jiujie51/RUI_lora_alarm/doc/项目方案梳理报告.md

# LoRa报警系统 — 方案梳理报告（终端设备视角）

> 2026-07-04 | NCS v3.3.0 | RAK4631 (nRF52840 + SX1262)
>
> **职责边界**：终端设备（Hub/Badge）由我们开发。服务器/LNS（SimulAlert）已部署，我们只需要遵守与服务器的协议约定。网关（RAK7289CV2）是现成设备，配置连到 LNS 即可。

---

## 一、系统架构与职责

```
┌──────────────────┐         ┌──────────────┐         ┌─────────────────────┐
│  Hub / Badge     │  LoRa   │ RAK7289CV2   │  WSS    │ SimulAlert LNS      │
│  (我们开发)       │ ←─────→ │ (现成, 配置)   │ ←─────→ │ wss://lns.simulalert │
│                  │  US915  │              │         │ .com:8887           │
│  RAK4631         │         │ Basic Station│         │                     │
│  NCS v3.3.0      │         │              │         │ + App Server        │
└──────────────────┘         └──────────────┘         │ + Dashboard         │
                                                       └─────────────────────┘
  我们的职责:                   网关职责:                   SimulAlert 职责:
  ✅ 0xAA55 协议编解码         ✅ LoRa ↔ IP 透传          ✅ 设备管理/入网
  ✅ OTAA 入网 (Class B)       ✅ GPS + Beacon            ✅ 协议编解码
  ✅ 告警状态机                 ✅ 频段匹配 US915           ✅ 告警路由/广播
  ✅ BLE 广播/扫描              ❌ 不解析 0xAA55            ✅ Dashboard
  ✅ 执行器 (LED/Buzz/Vib)                                  ✅ 多播组管理
  ❌ 不管理 Ping Slot                                       ✅ Ping Slot 配置
```

---

## 二、设备与服务器的约定（核心）

### 2.1 LoRaWAN 入网约定

| 约定项 | 设备侧（固件） | 服务器侧（SimulAlert LNS） |
|---|---|---|
| 入网方式 | OTAA | OTAA |
| MAC 版本 | 1.0.3 | 1.0.3 |
| Class | B | B |
| 频段 | US915 | US915 |
| 凭证写入 | 生产烧录到 Flash ConfigStore | DevEUI/JoinEUI/AppKey 预先注册 |
| AppKey | **一机一密**（固件从 ConfigStore 读取） | 每台设备独立注册 |
| NVM 持久化 | 启用（掉电不丢会话） | — |
| Ping Slot | **不管**（服务器 Device Profile 配置） | 由服务器侧配置周期 |
| 入网重试 | 无限重试 + 指数退避 (10s→20s→…→900s) | 入网请求无限制 |
| 离线模式 | 入网期间 BLE/OLED/按键正常可用 | — |

### 2.2 FPort 分配约定

| FPort | 方向 | 内容 | 说明 |
|---|---|---|---|
| 10 | 上行 | Badge 心跳 (CMD 0x00) | 必须与此 FPort 一致，服务器按此路由 |
| 11 | 上行 | Hub 心跳 (CMD 0x00) | 同上 |
| 20 | 上行 | 业务数据 (CMD 0x01/0x02) | 电量、按键事件 |
| 20 | 下行 | **全部下行**（单播+多播） | 通过 CMDID + group/room 区分 |

> ⚠️ Port 0/200/201/202 是 LoRaWAN MAC 层保留端口，设备固件不可占用。

### 2.3 应用帧格式约定（0xAA55 协议）

```
┌──────┬──────┬──────┬──────┬──────┬────────┬────────┬──────────┐
│ 0xAA │ 0x55 │ ver  │ ctrl │CMDID │length  │ CRC16  │  data    │
│  1B  │  1B  │  1B  │  1B  │  1B  │  2B BE │  2B    │   N B    │
└──────┴──────┴──────┴──────┴──────┴────────┴────────┴──────────┘
```

| 字段 | 长度 | 说明 |
|---|---|---|
| 帧头 | 2B | 固定 `0xAA 0x55` |
| ver | 1B | 协议版本，当前 `0x01` |
| ctrl | 1B | 控制标志，上行固定 `0x00` |
| CMDID | 1B | 指令 ID |
| length | 2B | 帧总长度（含帧头和 CRC），大端序 |
| CRC16 | 2B | CRC16/XMODEM (poly=0x1021, init=0x0000)，覆盖除 CRC 自身外全部字节 |
| data | N | 变长数据 |

**测试向量**：`{0xAA,0x55,0x01,0x00,0x00,0x08,0x00,0x03}` → CRC16 = `0x58C7`

### 2.4 上行 CMDID（设备 → 服务器）

| CMDID | 名称 | FPort | 触发条件 | data 格式 |
|---|---|---|---|---|
| 0x00 | Heartbeat | 10(Badge)/11(Hub) | 每 5min | `{dev_type(1B), group_id(1B)}` |
| 0x01 | Power | 20 | 电量变化≥5% 且间隔≥5min | `{dev_type(1B), power_pct(1B)}` |
| 0x02 | KeyEvent | 20 | 按键确认 + BLE 扫描完成 | `{button(1B), motion(1B), rssi(1B), hub_mac(6B), lat(4B), lon(4B)}` |

**字段说明**：
- `dev_type`: `0x00`=Badge, `0x01`=Hub
- `button`: 按键 ID (Red/Blue/Yellow/Green), `0xFF`=静默定位
- `motion`: 保留（运动检测），当前填 `0`
- `rssi`: BLE 扫描到的 Hub RSSI，取绝对值（无符号）
- `hub_mac`: BLE 扫描到的最强 Hub 的 MAC 地址（6 字节），无 Hub 时填 `00:00:00:00:00:00`
- `lat/lon`: int32 大端，GPS 有效时填坐标，无效时填 `0x90000001` / `0x18000001`

### 2.5 下行 CMDID（服务器 → 设备）

| CMDID | 名称 | 方向 | 设备处理 |
|---|---|---|---|
| 0x03 | Code（告警） | 多播 | group_id + room_id 过滤 → alarm_sm_set() |
| 0x04 | Code Setting | 单播 | 更新 actuator 配置 → Flash 保存 |
| 0x05 | LED Control | 单播 | 直接控 LED |
| 0x06 | Buzzer Control | 单播 | 直接控蜂鸣器 |
| 0x07 | Vibration Control | 单播 | 直接控振动（仅 Badge） |
| 0x08 | LCD Content | 单播 | LCD 双行文字（仅 Badge） |
| 0x09 | LCD Line2 On/Off | 单播 | LCD 第二行开关（仅 Badge） |
| 0x0A | Clear Packet | 多播 | group_id + room_id 过滤 → alarm_sm_clear() |
| 0x50 | Set Group ID | 单播 | 更新 group_id → Flash |

### 2.6 多播过滤约定（应用层）

CMD 0x03 和 0x0A 通过**多播帧下发**，设备侧在应用层做双重过滤：

```
服务器下发多播帧 (CMD 0x03/0x0A)
  data = {group_id(1B), alarm_type或clear_type(1B), room_id(1B, 可选)}
              │
              ▼
  设备收到 → group_id 匹配?
              ├─ group_id & 设备 group_id == 0 → 不匹配，丢弃
              ├─ group_id = 0xFF → 全校广播，命中全部
              └─ 命中 → room_id 匹配? (如果 data 中有 room_id)
                         ├─ room_id = 0xFF 或 0 → 匹配全部房间
                         ├─ room_id = 设备 room_id → 命中
                         └─ 不匹配 → 丢弃
```

### 2.7 告警类型约定

| 优先级 | 类型 | 类型值 | 广播范围 | 触发源 |
|---|---|---|---|---|
| P0 | Code Red | 0x01 | 全校 (group=0xFF) | Red 按键 / Dashboard |
| P1 | Shelter | 0x08 | 全校 | Dashboard |
| P2 | Evacuate | 0x07 | 全校 | Dashboard |
| P3 | Secure | 0x06 | 全校 | Dashboard |
| P4 | Hold | 0x05 | 全校 | Dashboard |
| P5 | Medical (Blue) | 0x02 | Admin+Nurse 组 | Blue 按键 |
| P6 | Admin (Yellow) | 0x03 | Admin 组 | Yellow 按键 |
| P7 | All Clear (Green) | 0x04 | 全校 | Green 按键 / Dashboard |
| P8 | Normal | — | — | 默认空闲 |

### 2.8 设备身份约定

| 身份属性 | 长度 | 说明 | 设置方式 |
|---|---|---|---|
| DevEUI | 8B | 设备唯一标识 | 生产烧录 |
| JoinEUI | 8B | 入网域标识（全网统一） | 生产烧录 |
| AppKey | 16B | 入网根密钥（一机一密） | 生产烧录 |
| group_id | 1B | 角色 bitmask（Bit0=Admin, Bit1=Nurse...） | 服务器 CMD 0x50 远程设置 |
| room_id | 1B | 房间编号 | 服务器 CMD 0x50 / 生产烧录 |

---

## 三、网关配置（RAK7289CV2）

### 3.1 连接 SimulAlert LNS

RAK7289CV2 使用 **Basic Station** 协议连接 LNS：

| 配置项 | 值 |
|---|-----|
| LNS 地址 | `wss://lns.simulalert.com:8887` |
| 协议 | WebSocket Secure (Basic Station) |
| 认证 | TLS 证书 / Token（由 SimulAlert 提供） |
| 频段 | US915 |
| GPS | **必须 Lock**（否则 Class B Beacon 不发送） |
| Class B Beacon | **必须 Enable** |

### 3.2 网关必须满足的条件

| 条件 | 原因 | 不满足的后果 |
|---|---|---|
| GPS Lock | Class B 需要全网时间同步 | 无 Beacon → 设备收不到下行 → Class A 退化 |
| 频段匹配 US915 | 与设备一致 | 收不到设备上行 |
| Beacon 周期 128s | LoRaWAN 标准 | 设备 ping slot 偏移基于此计算 |
| LNS 连接稳定 | 下行命令需实时转发 | 下行延迟增加或丢失 |

---

## 四、设备侧必须实现的功能

### 4.1 Hub

| 功能 | 说明 | 状态 |
|---|---|---|
| OTAA 入网 (Class B) | DevEUI/JoinEUI/AppKey 从 ConfigStore 读取 | ✅ 已实现 |
| 心跳上行 (FPort 11) | 每 5min, CMD 0x00 | ✅ |
| 电量上行 (FPort 20) | delta≥5%, CMD 0x01 | ✅ |
| 下行命令处理 | CMD 0x03/0x04/0x05/0x06/0x0A/0x50 | ✅ |
| 告警状态机 | 多优先级抢占 + All Clear/Clear All | ✅ |
| WS2812 LED 级联 | 12 灯珠，GRB 序，P0.20 单 GPIO | ✅ |
| 高分贝蜂鸣器 | PWM 驱动，Red 60s/其他 30s 自动停 | ✅ |
| BLE 广播 | 2s 间隔，"ALARM_HUB" + MAC + room_id | ✅ |
| NVM 持久化 | 掉电不丢会话 | ✅ |
| MCUboot OTA | ECDSA P-256 签名 | ✅ |

### 4.2 Badge

| 功能 | 说明 | 状态 |
|---|---|---|
| OTAA 入网 (Class B) | 同上 | ✅ |
| 心跳上行 (FPort 10) | 同上 | ✅ |
| 电量上行 (FPort 20) | 同上 | ✅ |
| 4 按键状态机 | 短按/长按/组合键/Code Red 二次确认 | ✅ |
| BLE 扫描定位 | 报警 4s 全速 / 静默 1s 每 30s | ✅ |
| RSSI 定位算法 | 中位数 + 6dB 阈值 | ✅ |
| GPS 定位 (RAK12501) | UART 9600bps, NMEA $GPGGA/$GPRMC | ✅ |
| 双 RGB LED (PWM) | 6 通道 PWM | ✅ |
| 蜂鸣器 (PWM) | Code Red 60s | ✅ |
| 振动马达 (GPIO) | MOS 驱动 | ✅ |
| LCD (SPI/I2C) | 双行 20 字 | ⚠️ 驱动桩，待硬件确认 |
| 按键事件上行 (FPort 20) | CMD 0x02 + BLE/GPS 定位数据 | ✅ |
| 下行命令处理 | 全部 CMDID | ✅ |
| 低电量保护 | <10% 时 LED/蜂鸣器 50%，振动禁用 | ✅ |

---

## 五、BLE 与 LoRa 协同（设备侧）

### 5.1 角色分工

```
Hub (固定)                          Badge (移动)
────────                            ────────
BLE: Peripheral Broadcaster         BLE: Observer Scanner
  广播 "ALARM_HUB"                    扫描 Hub 广播
  + MAC + room_id                    + 取 RSSI → 选最强
  + 间隔 2s                          + 报警时 4s 全速扫描

LoRa: Class B                       LoRa: Class B
  收下行 (CMD 0x03/0x0A)             发上行 (CMD 0x02)
                                     收下行 (CMD 0x03)
```

### 5.2 Code Red 触发全链路（设备视角）

```
Badge 按键确认 (Red 长按 5s)
  │
  ├─ BLE 扫描 4s → 收集 Hub RSSI → 选最强 Hub MAC
  │
  ├─ GPS 检查: 有效→填坐标, 无效→填无效标记
  │
  └─ LoRa 上行 CMD 0x02 (FPort 20, Unconfirmed)
       {button=Red, rssi, hub_mac, lat, lon}
              │
              ▼
         [服务器处理 → 多播 CMD 0x03]
              │
              ▼
         所有设备在 Class B Ping Slot 收到 CMD 0x03
         → alarm_sm_set(CODE_RED)
         → LED 红闪 + 蜂鸣 60s + 振动
```

---

## 六、待明确事项（需要与 SimulAlert 方确认）

| # | 事项 | 说明 |
|---|---|---|
| 1 | **Device Profile 参数** | 服务器侧 Class-B ping slot period、RX1/RX2 delay、ADR 策略等 |
| 2 | **设备注册方式** | DevEUI/JoinEUI/AppKey 如何批量导入 LNS？提供 CSV 还是 API？ |
| 3 | **AppKey 分配** | 是否由 SimulAlert 生成并统一管理？还是我们可以自己生成后导入？ |
| 4 | **多播组配置** | 全校广播组 / Admin 组 / Nurse 组的 McDevAddr 由谁创建？ |
| 5 | **ChirpStack → SimulAlert LNS** | SimulAlert LNS 是基于 ChirpStack 还是自研？API 协议是否兼容？ |
| 6 | **网关 TLS 证书** | 连接 `wss://lns.simulalert.com:8887` 需要什么证书/Token？ |
| 7 | **下行 CMD 0x03 group_id 编码** | 确认多播帧 data 中 group_id 和 room_id 的字节序和格式 |
| 8 | **CRC16 实现确认** | 服务器侧 CRC16 算法是否与设备一致（poly=0x1021, init=0x0000）？ |
| 9 | **OTA 升级方案** | MCUboot 签名密钥由谁管理？OTA 通过 LoRaWAN 还是 BLE？ |

---

## 七、当前固件状态

| 配置项 | 值 |
|---|-----|
| NCS 版本 | v3.3.0 |
| 频段 | US915 |
| MAC 版本 | 1.0.3 |
| Class | B |
| 认证方式 | OTAA |
| 凭证存储 | ConfigStore (NVS Flash) + Kconfig fallback |
| NVM 持久化 | 启用 |
| Ping Slot | 服务器配置（应用层不管） |
| MCUboot | 启用，ECDSA P-256 签名 |
| 编译 | Badge + Hub 双变体通过 |

| 变体 | FLASH | RAM |
|---|---|-----|
| Badge | 211 KB (42.6%) | 57.3 KB (21.9%) |
| Hub | 217 KB (44.0%) | 59.8 KB (22.8%) |
