jiujie51/RUI_lora_alarm/doc/client_doc/Devices behavior summary.docx

Devices Behavior Summary

Below table summarizes how the devices behave under different scenarios.

Notes:

1. Remember that for any badge button-initiated alert, a prompt to confirm must appear on the LCD screen and must be pressed within 4 seconds or alert is not sent. Short press shows battery status on LCD.
2. The badge and hub LEDs do not light/illuminate continuously, they flash for defined internal and duration to conserve battery power
3. The badge does not vibrate continuously, they vibrate for some defined time and then stop to conserve battery power
4. The badge and hub buzzers do not sound continuously. They buzz for some defined time and then stop to conserve battery power
5. For SRP alerts (Initiated from Dashboard), the staff may be required to provide status via their badge, for example:
  a. Press Blue for medical assistance
  b. Press yellow for missing students

Command | Trigger Source | Target | LED illumination Color (Badge &Hub) | Buzzer (Badge / Hub) | Vibration (Badge only) | Badge LCD Message
Lockdown | Red - Button press | All Badges & Hubs | Red | Yes - all | All | Code Red Room XXX
Medical | Blue -Button press | Initiating badge and associated DoorHub | Blue for that badge plus admin and nurses badges only, Blue for DoorHub for that room only | Yes – initiating badge, admin & nurses’ badges only. Not Hub | Yes target badges (initiating badge, nurses and admin badges) | Medical Alert Room XXX
Admin help | Yellow - Button press | Initiating badge and associated DoorHub | Yellow for that badge plus admin and nurses badges only, Yellow for DoorHub for that room only | Yes – initiating badge, and admin badges only. Not Hub | Yes target badges (initiating and admin badges) | Admin Alert Room XXX
All Clear (Room) | Green - Button press | Initiating badge and associated DoorHub | Green for that badge only, Green for DoorHub for that room only | Yes – Badge only | Yes | All Clear
Set All Clear Status | Dashboard only | All Badges & Hubs | Green | Yes - all | All | All Clear
Clear All Statues | Dashboard only | All Badges & Hubs | None | None | None | None
Hold | Dashboard only | All Badges & Hubs | Purple | All badges, Not Hubs | All | Hold Alert
Secure | Dashboard only | All Badges & Hubs | Blue | All badges, Not Hubs | All | Secure Alert
Evacuate | Dashboard only | All Badges & Hubs | Green | All badges, Not Hubs | All | Evacuate Alert
Shelter | Dashboard only | All Badges & Hubs | Orange | All badges, Not Hubs | All | Shelter Alert
Reset badge | Long press Yelow+Green | Individual badge | Flash white when resetting | None | Yes | Firmware Version
Text | Dashboard only | Individual badges | None | Yes, badge only | Yes | [Short text from admin]
