jiujie51/RUI_lora_alarm/doc/RAK12500对比RAK12501.png

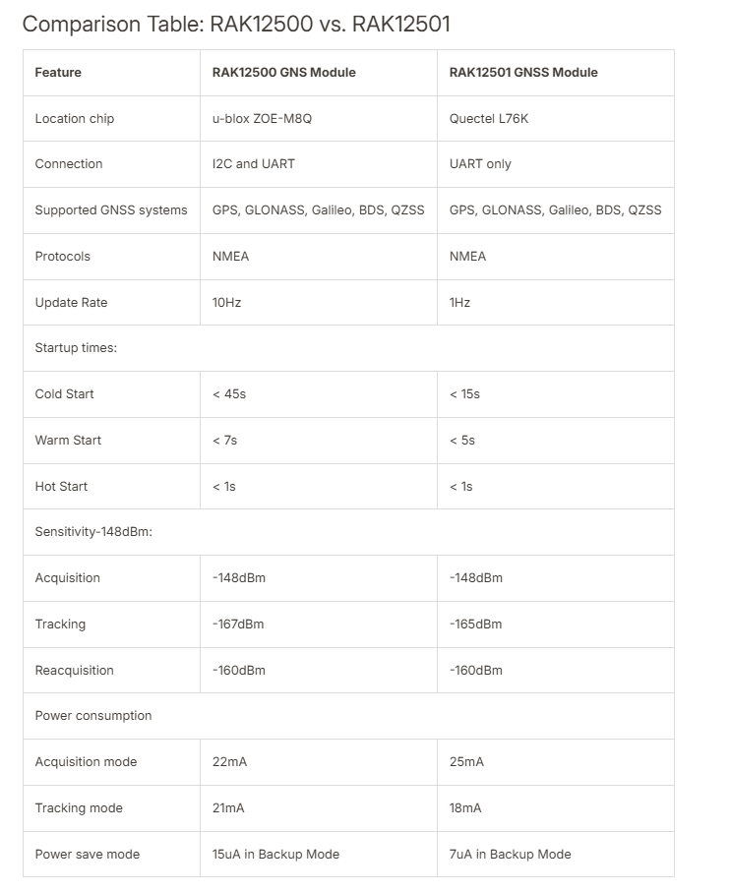
doc/RAK12500对比RAK12501.png
