jiujie51/RUI_lora_alarm/doc/badge_SCH/Badge.pdf

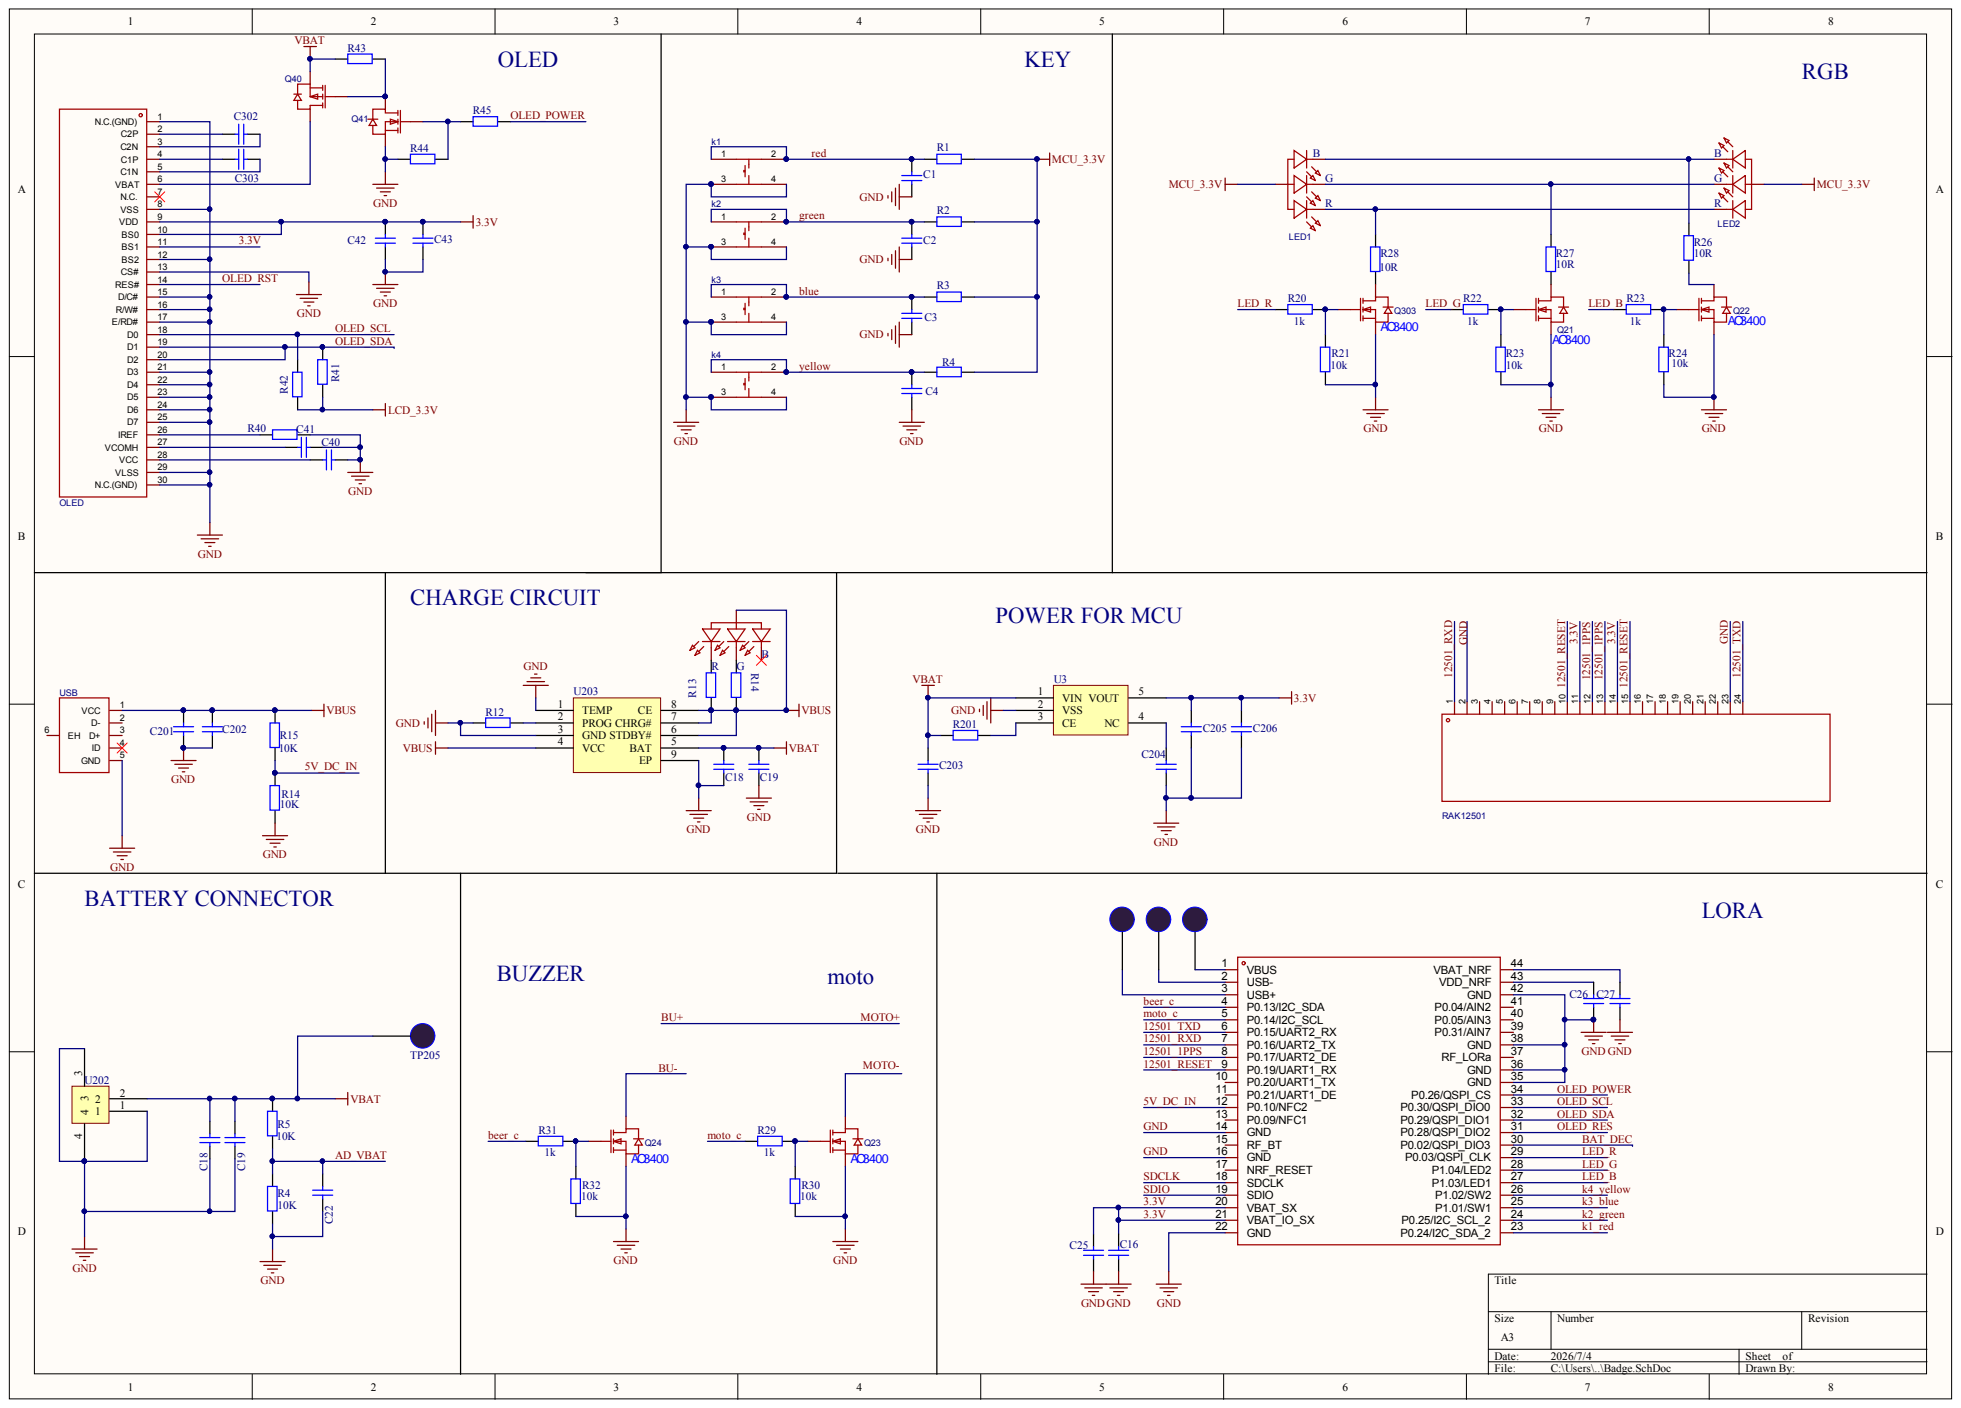
[picture p7: page 1]
