jiujie51/RUI_lora_alarm/doc/hub-SCH/hub-SCH.pdf

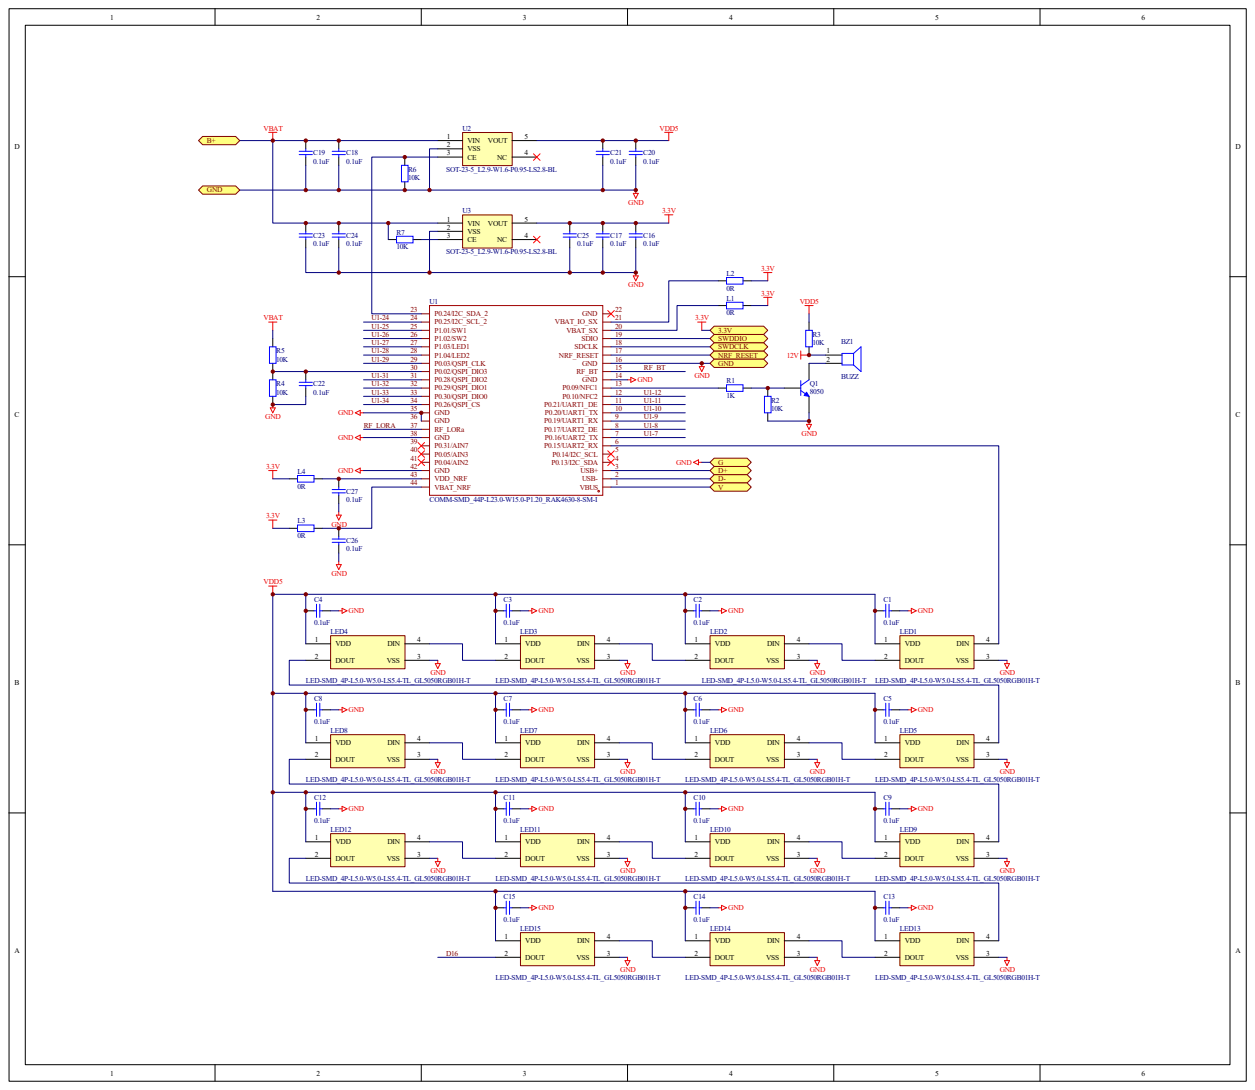
[picture p8: page 1]
