jiujie51/RUI_lora_alarm/(list of files, drawings)

Other design files:
doc/badge_SCH/Badge.SchDoc
doc/hub-SCH/hub.PCBDOC
doc/hub-SCH/PCB_Project1.PrjPCB
