jiujie51/RUI_lora_alarm/(commit log)

2026-07-22 完成hub的ble广播、lorawan入网和硬件驱动
    [Badge.SchDoc, PCB_Project1.PrjPCB, devices_20260618_badge.csv, devices_20260618_badge.xlsx, devices_20260618_hub.csv, devices_20260618_hub.xlsx, hub.PCBDOC, hub.Sch]
2026-07-23 完成基本功能，缺少oled，classB beacon lock测试，badge蜂鸣器和马达还有缺陷
2026-07-26 badge 按键事件完善
2026-07-26 完成gps 驱动
2026-07-26 对照协议和需求文档，补齐需求，将设备行为配置存储flash
2026-07-26 打开oled，hub的设备行为配置固化到flash
2026-07-28 oled 软件i2c ok scl 和 sda 交换
2026-07-29 oled 驱动更新
2026-07-29 oled显示内容更新，按照需求来
2026-08-01 完成classb beacon lock，多播设定 多播尝试要修改为下行频率
2026-08-01 完善协议解析，使用整个字符串解析方法，不用流式处理
2026-08-01 1、打开gps 2、多播先查再注册
2026-08-03 完成key event 功能测试
2026-08-03 完成OLED 硬件i2c 100k，刷新率提升，点不亮屏，是硬件问题，i2c通信异常会卡在oled初始化
2026-08-04 硬件i2c
2026-08-08 hub 硬件自测试
    [pwm config.txt]
2026-08-08 完成多播设定测试、修正业务逻辑（code event）、将设备信息写入flash 方便生产、优化lorawan消息发送
